arcadien/ir-tracker/renders/arm_top.png

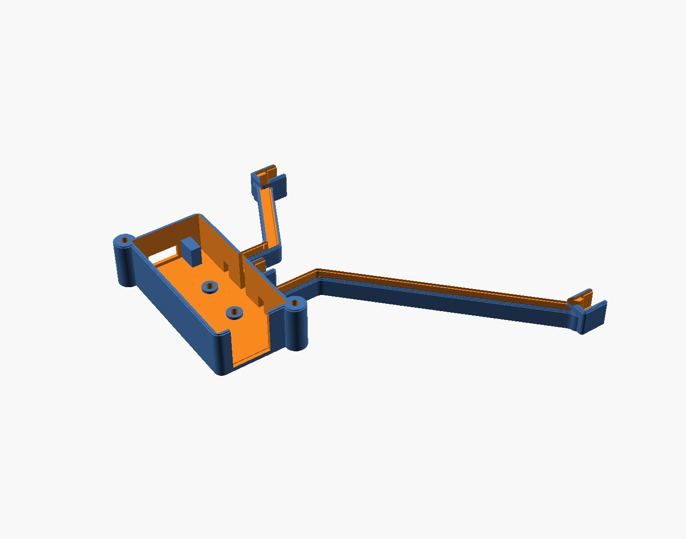
renders/arm_top.png
