arcadien/ir-tracker/renders/clamp.png

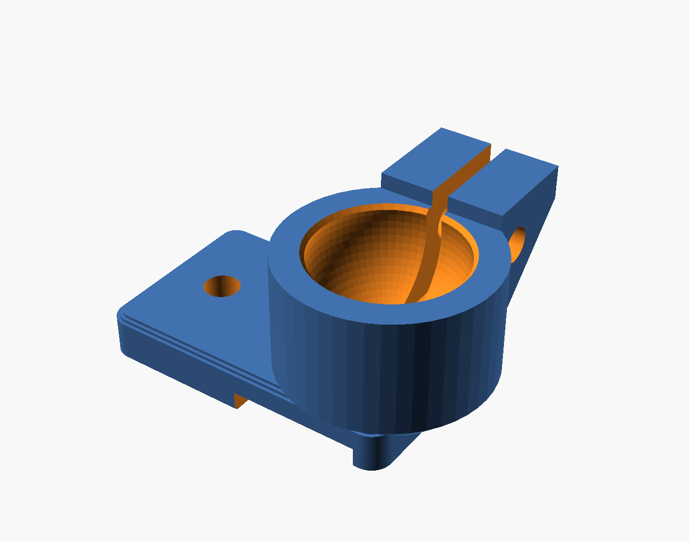
renders/clamp.png
