arcadien/ir-tracker/ir-tracker.3mf

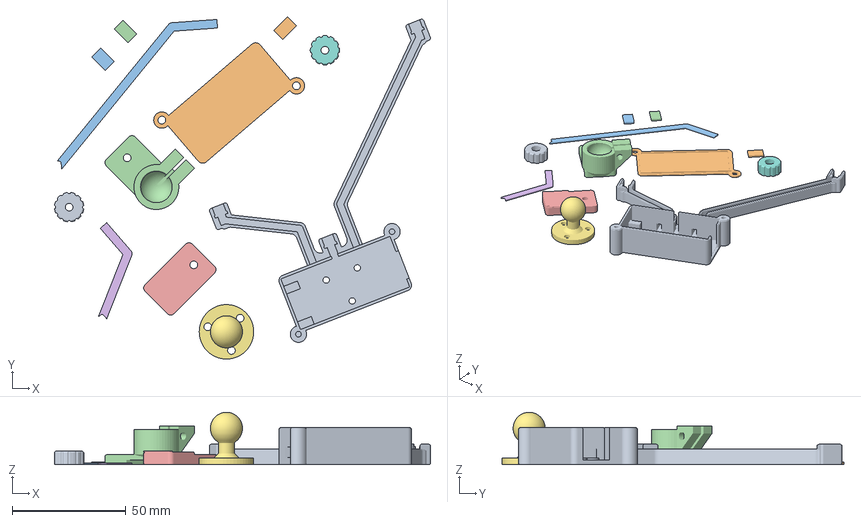
[picture p7: CAD file, 2026-10-23]
ir-tracker.3mf
165.6 x 150.7 x 23.1 mm
irtracker_arm.stl
irtracker_lid.stl
irtracker_cover_b.stl
irtracker_clamp_outer.stl
irtracker_clamp_inner.stl
irtracker_cover_ft.stl
irtracker_ball.stl
irtracker_knob.stl x 2
irtracker_led_cap_T.stl
irtracker_led_cap_F.stl
irtracker_led_cap_B.stl
