arcadien/ir-tracker/(commit log)

2026-10-23 IR Tracker: 3-LED infrared head-tracking clip for the HyperX Cloud II Wireless
    Parametric OpenSCAD model (TrackClip Pro LED geometry, battery box, fork clamp,
    ball joint), OrcaSlicer project, check/build scripts, renders and design notes.
    [ir-tracker.3mf, ir-tracker.scad]
2026-10-23 Docs: resistors go on the junction board, not on the LED legs
    The legs bend down the printed slot right behind the flange, leaving no room
    for a resistor there.
    [ir-tracker.scad]
2026-10-23 Docs: assembly order from the working build, opentrack result
